kpreid/3dp-connector-adapter-box/(commit log)

2019-06-13 First draft, doesn't work because you can't pass all-my-children-not-unioned to a module.
    [bnc-3.5mm-adapter.scad]
2019-06-13 More details, but the cutout shaping is not working.
    [bnc-3.5mm-adapter.scad]
2019-06-14 Flipped upside down.
    [bnc-3.5mm-adapter.scad]
